WindingMotor/Hub-2.0/documentation/images/Hub-2.0-ECU_INTERFACE.png

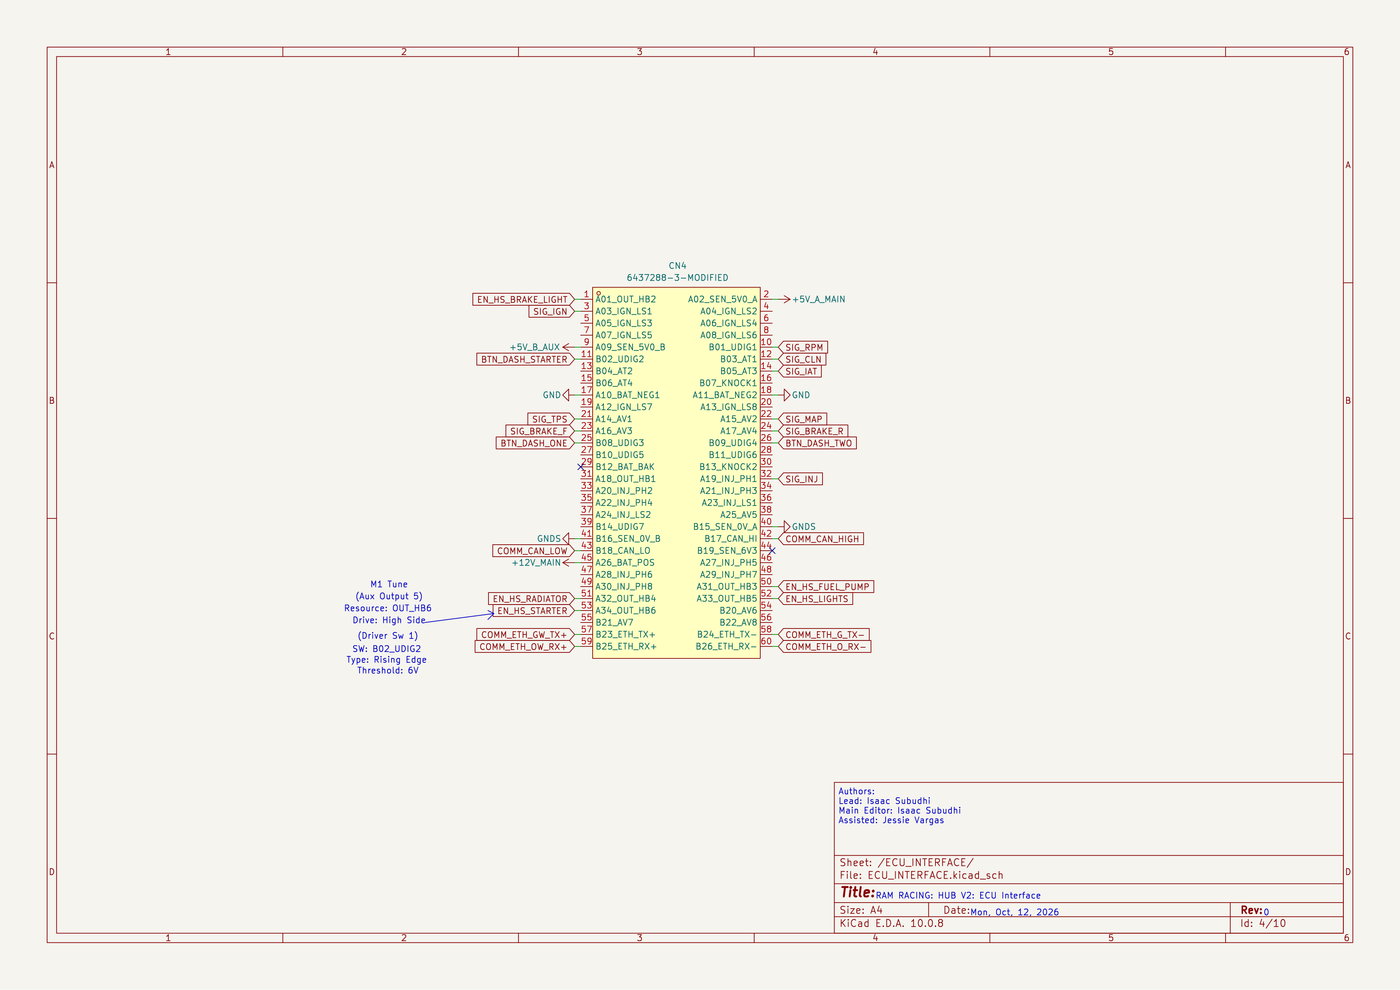
documentation/images/Hub-2.0-ECU_INTERFACE.png
