WindingMotor/Hub-2.0/documentation/images/Hub-2.0-EXTERNAL_CONNECTORS.png

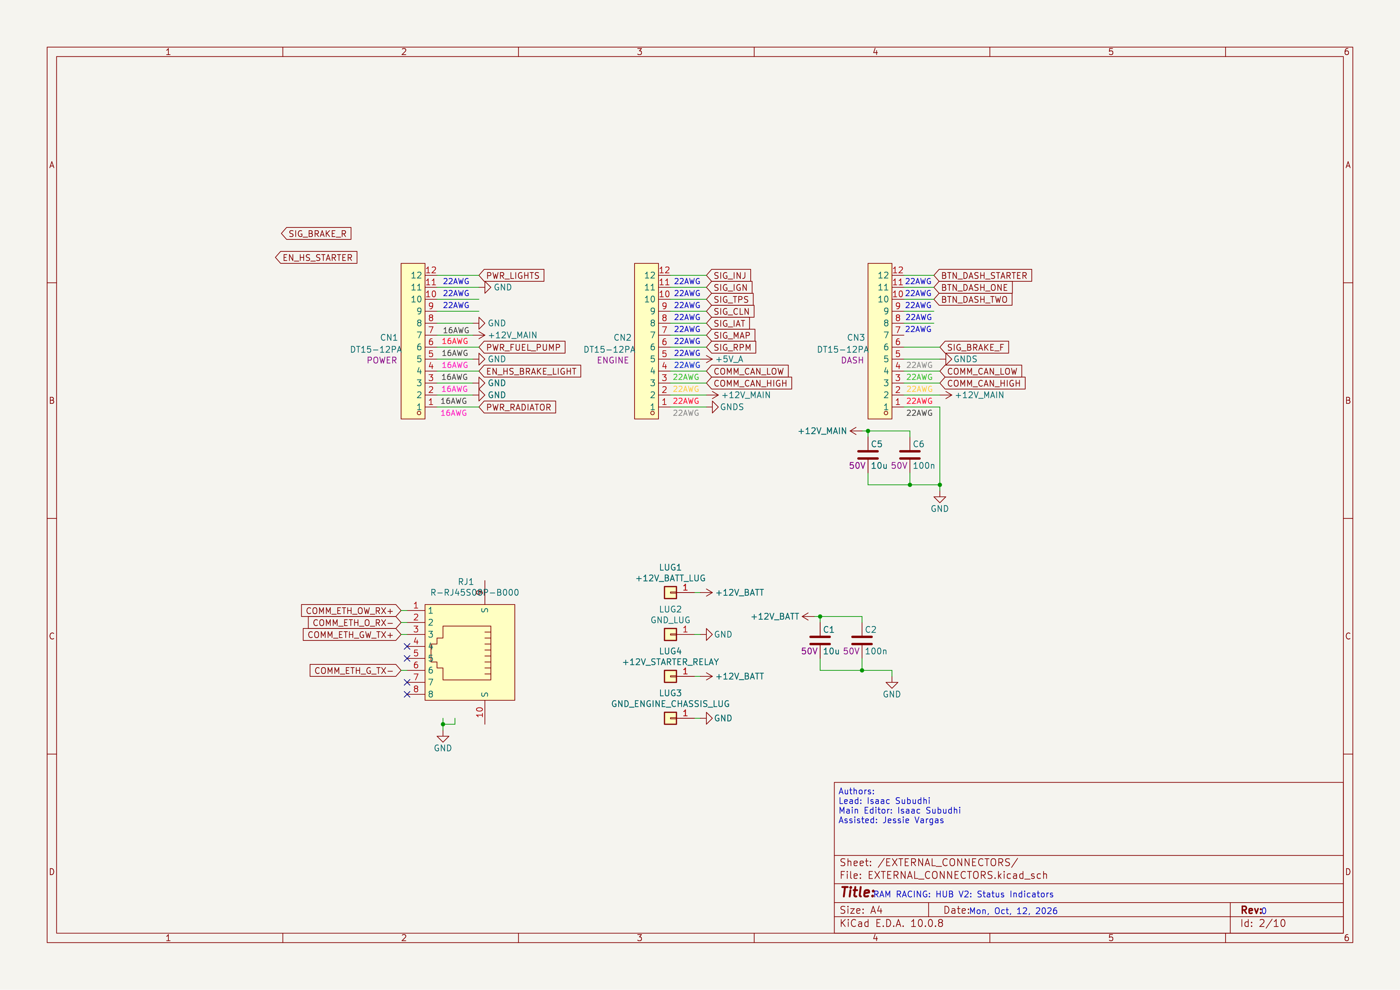
documentation/images/Hub-2.0-EXTERNAL_CONNECTORS.png
