WindingMotor/Hub-2.0/documentation/images/Hub-2.0-LOW_POWER_RELAYS.png

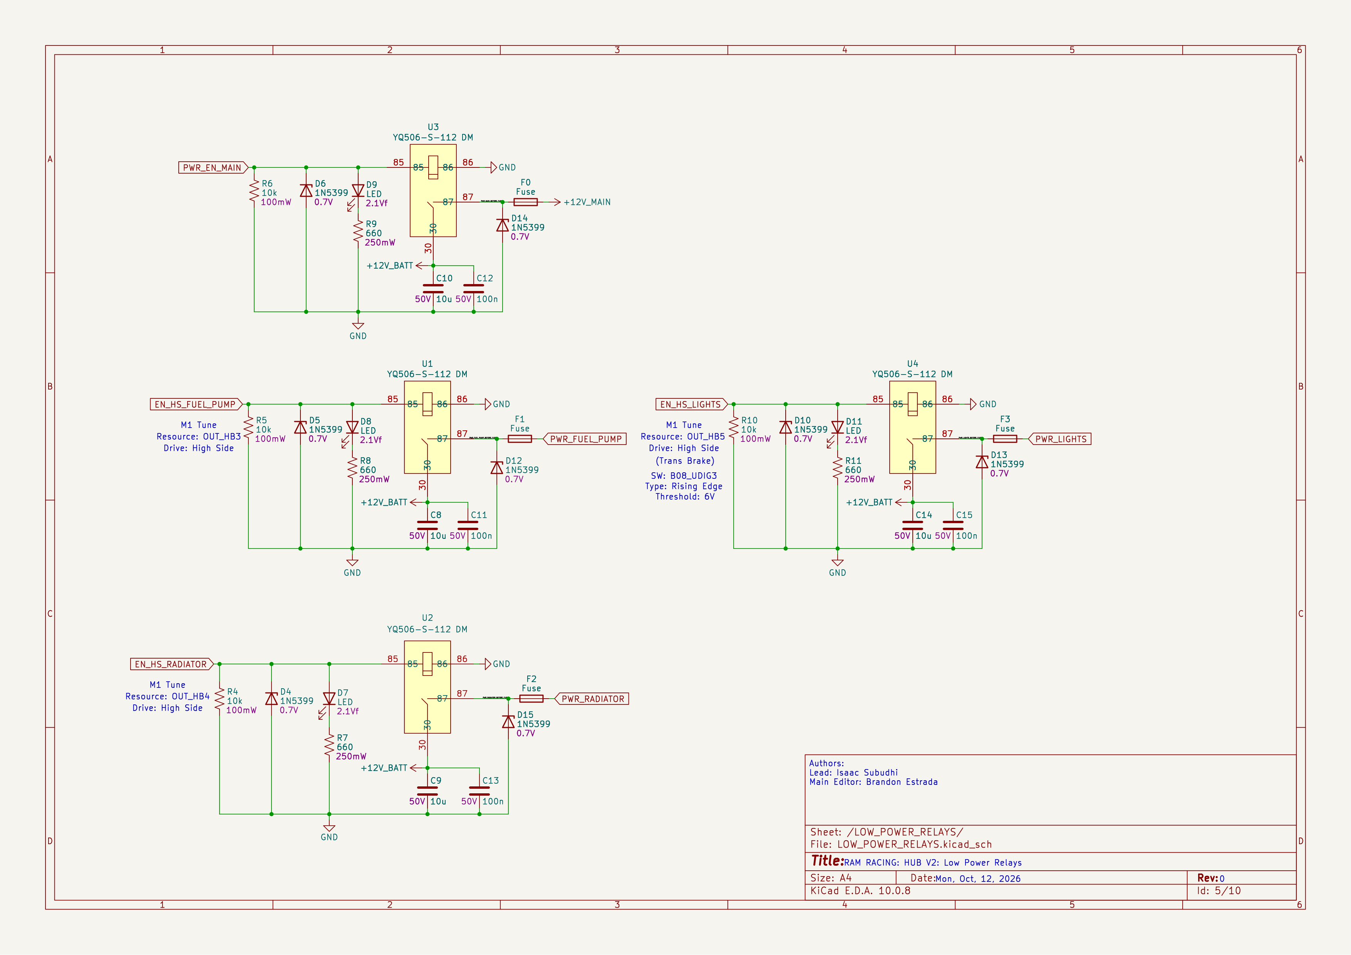
documentation/images/Hub-2.0-LOW_POWER_RELAYS.png
