WindingMotor/Hub-2.0/documentation/images/Hub-2.0-STATUS_INDICATORS.png

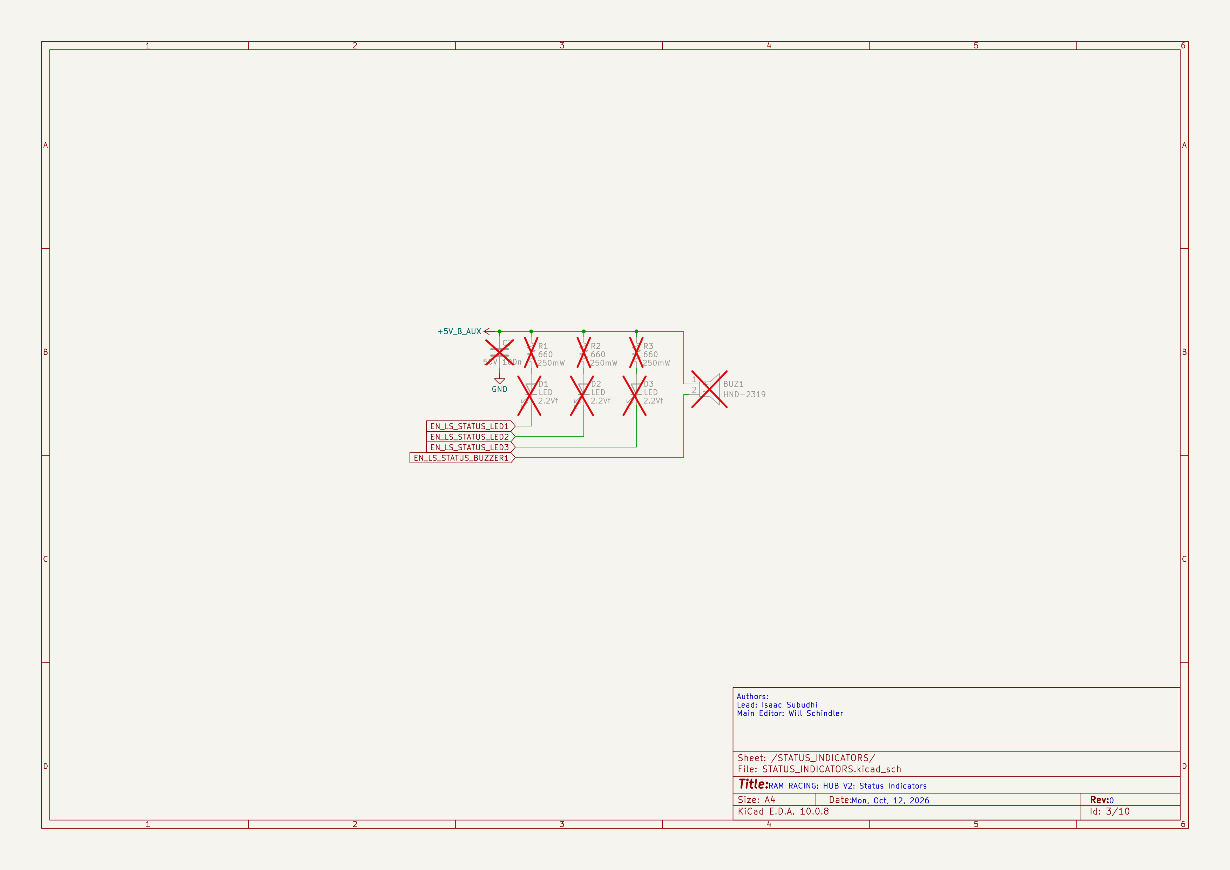
documentation/images/Hub-2.0-STATUS_INDICATORS.png
