WindingMotor/Hub-2.0/documentation/images/Hub-2.0.png

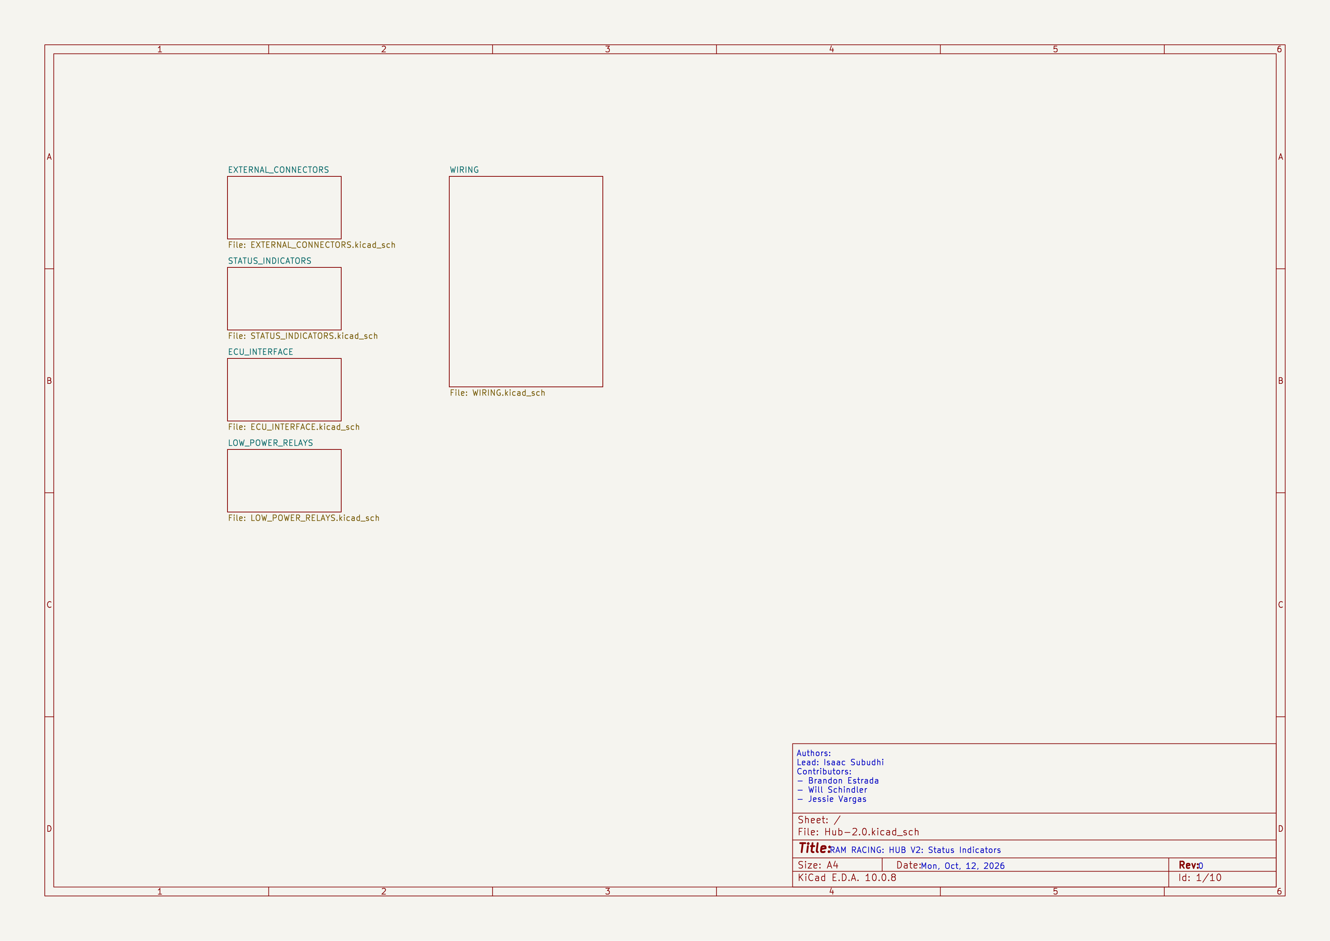
documentation/images/Hub-2.0.png
