WindingMotor/Hub-2.0/documentation/images/Hub-2.0-WIRING-SAFETY.png

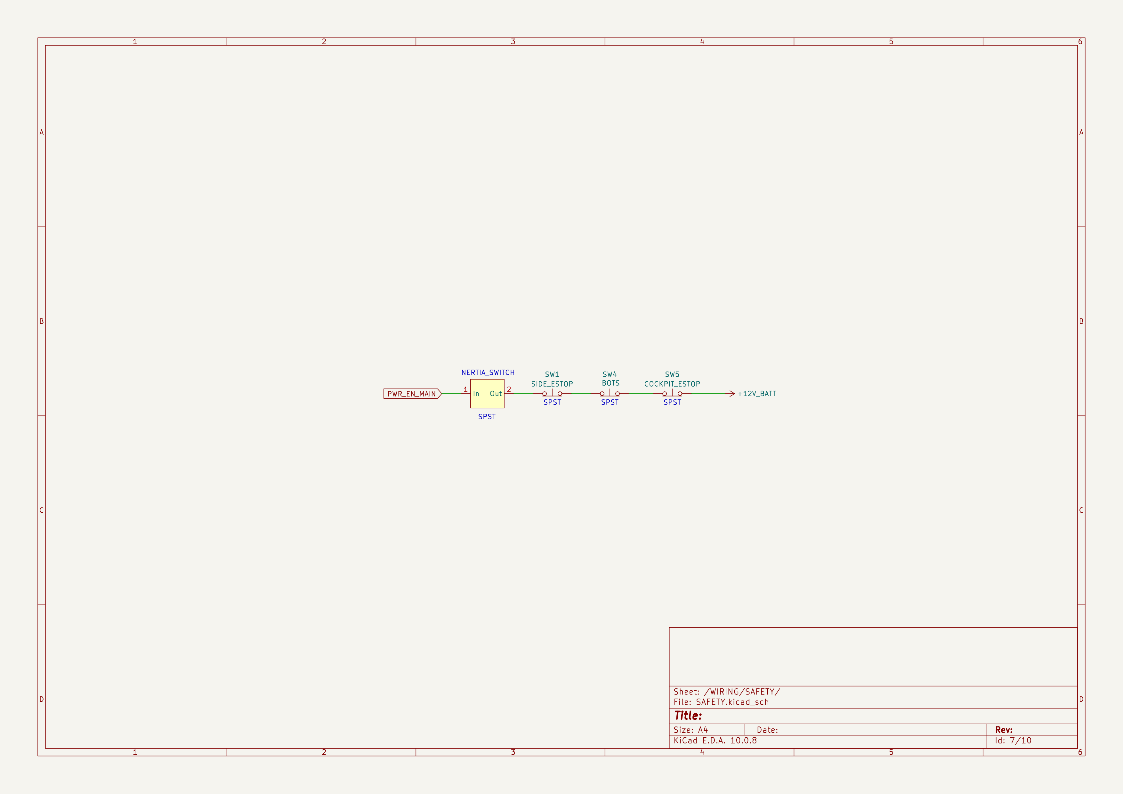
documentation/images/Hub-2.0-WIRING-SAFETY.png
