WindingMotor/Hub-2.0/documentation/images/Hub-2.0.pdf

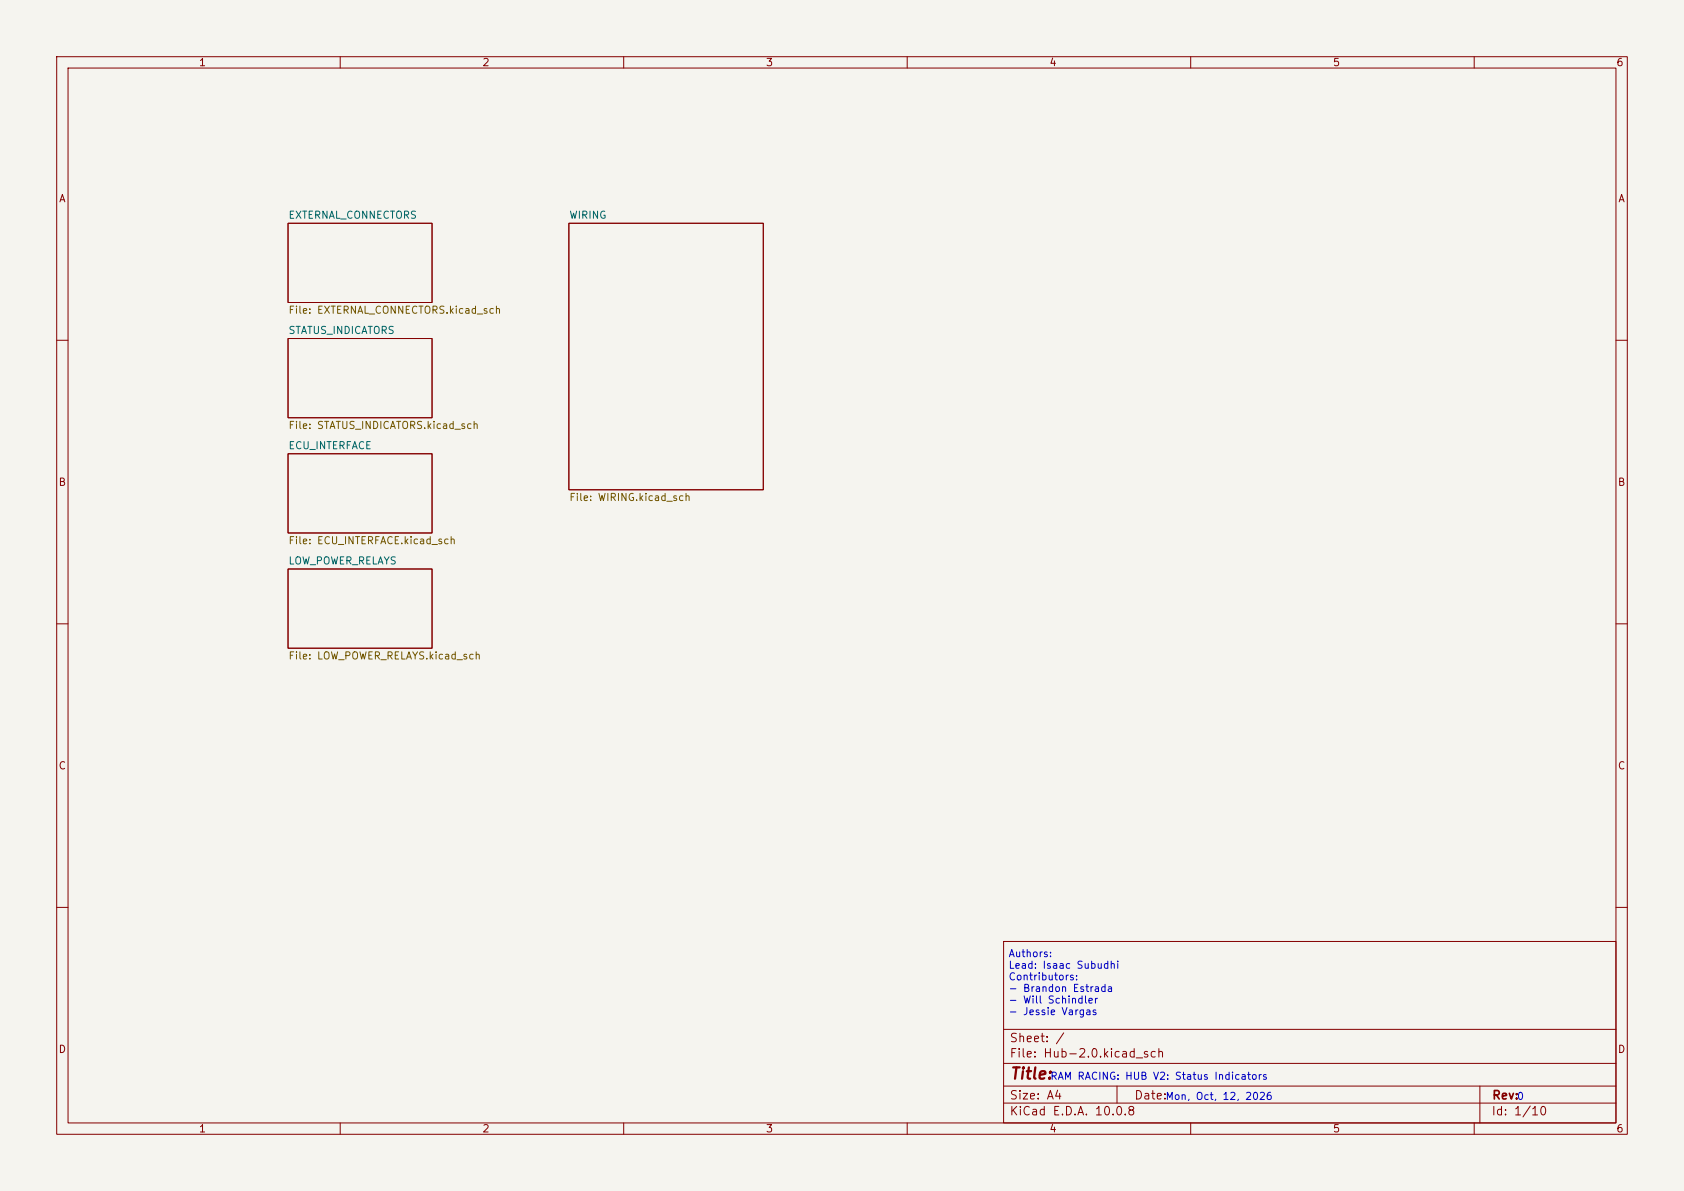
[picture p8: page 1]

Size: A4 | Rev:
KiCad E.D.A. 10.0.8 | Id: 1/10

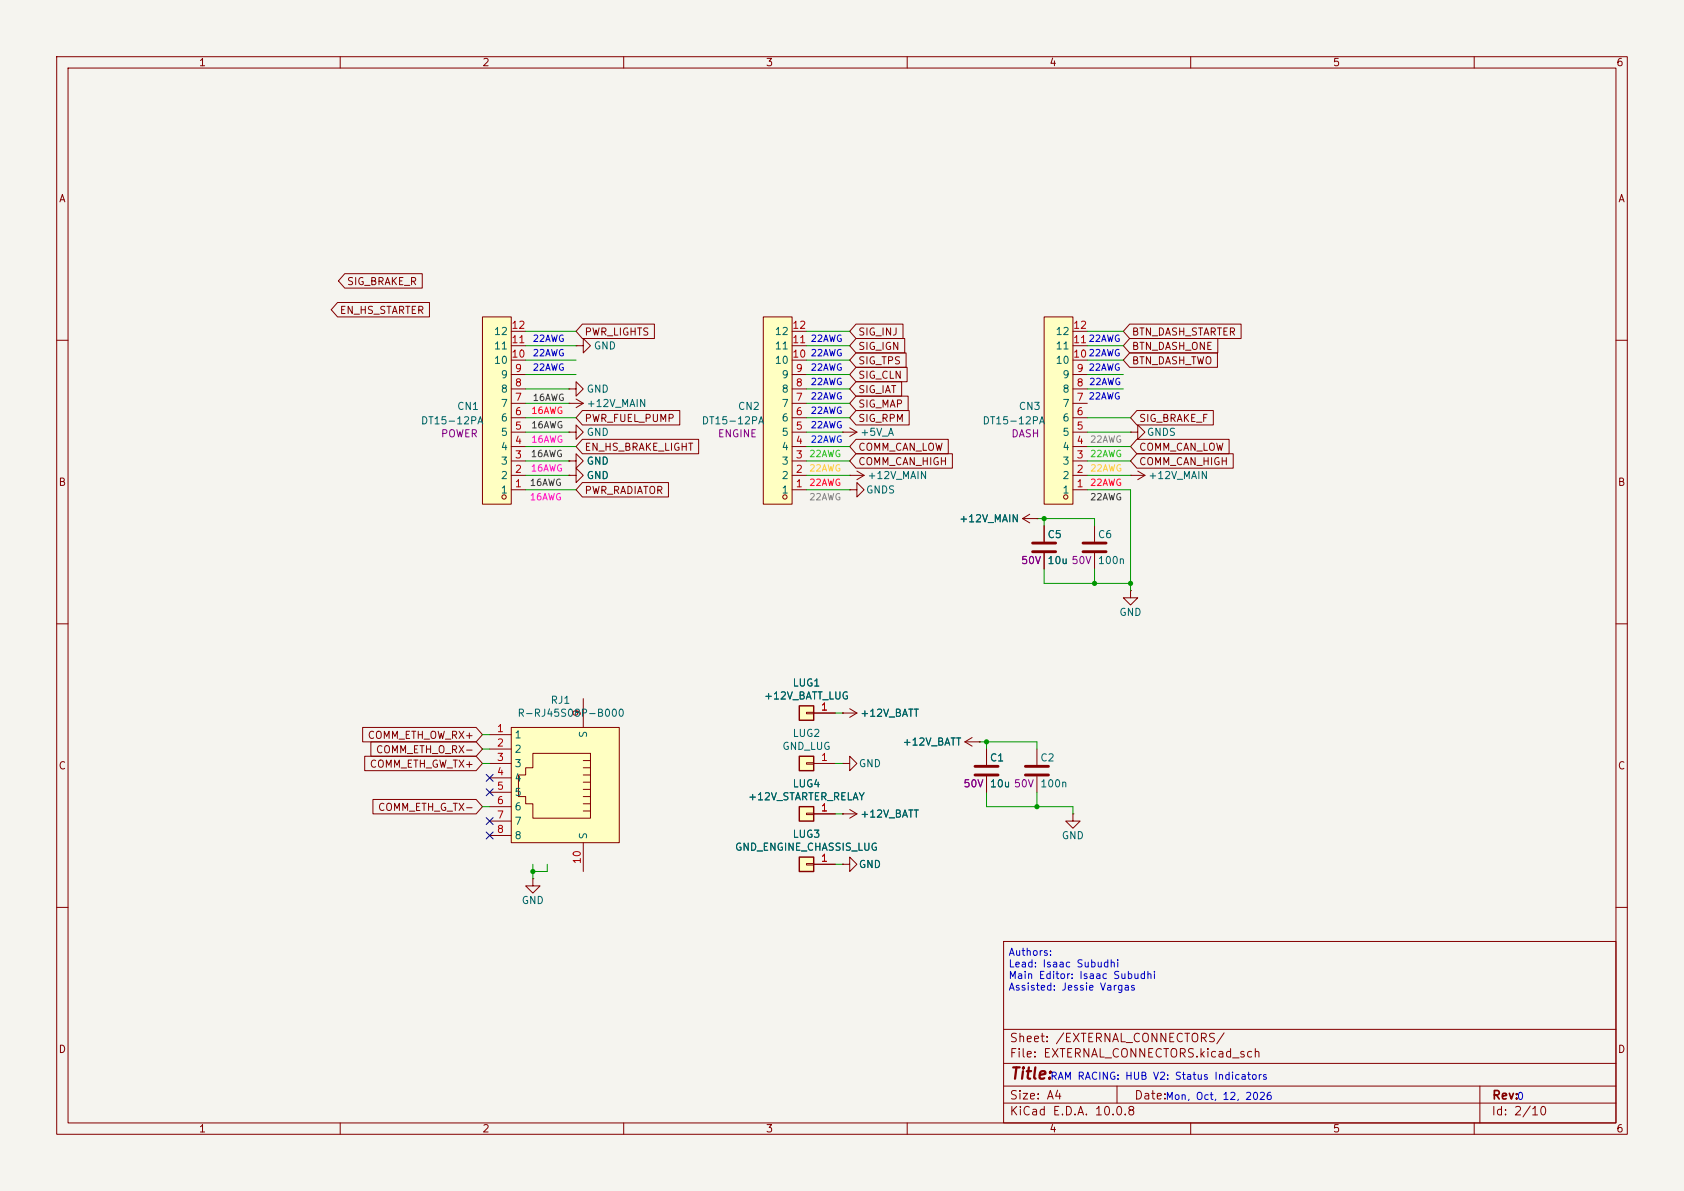
[picture p9: page 2]

Authors: Lead: Isaac Subudhi Main Editor: Isaac Subudhi Assisted: Jessie Vargas

RAM RACING: HUB V2: Status Indicators

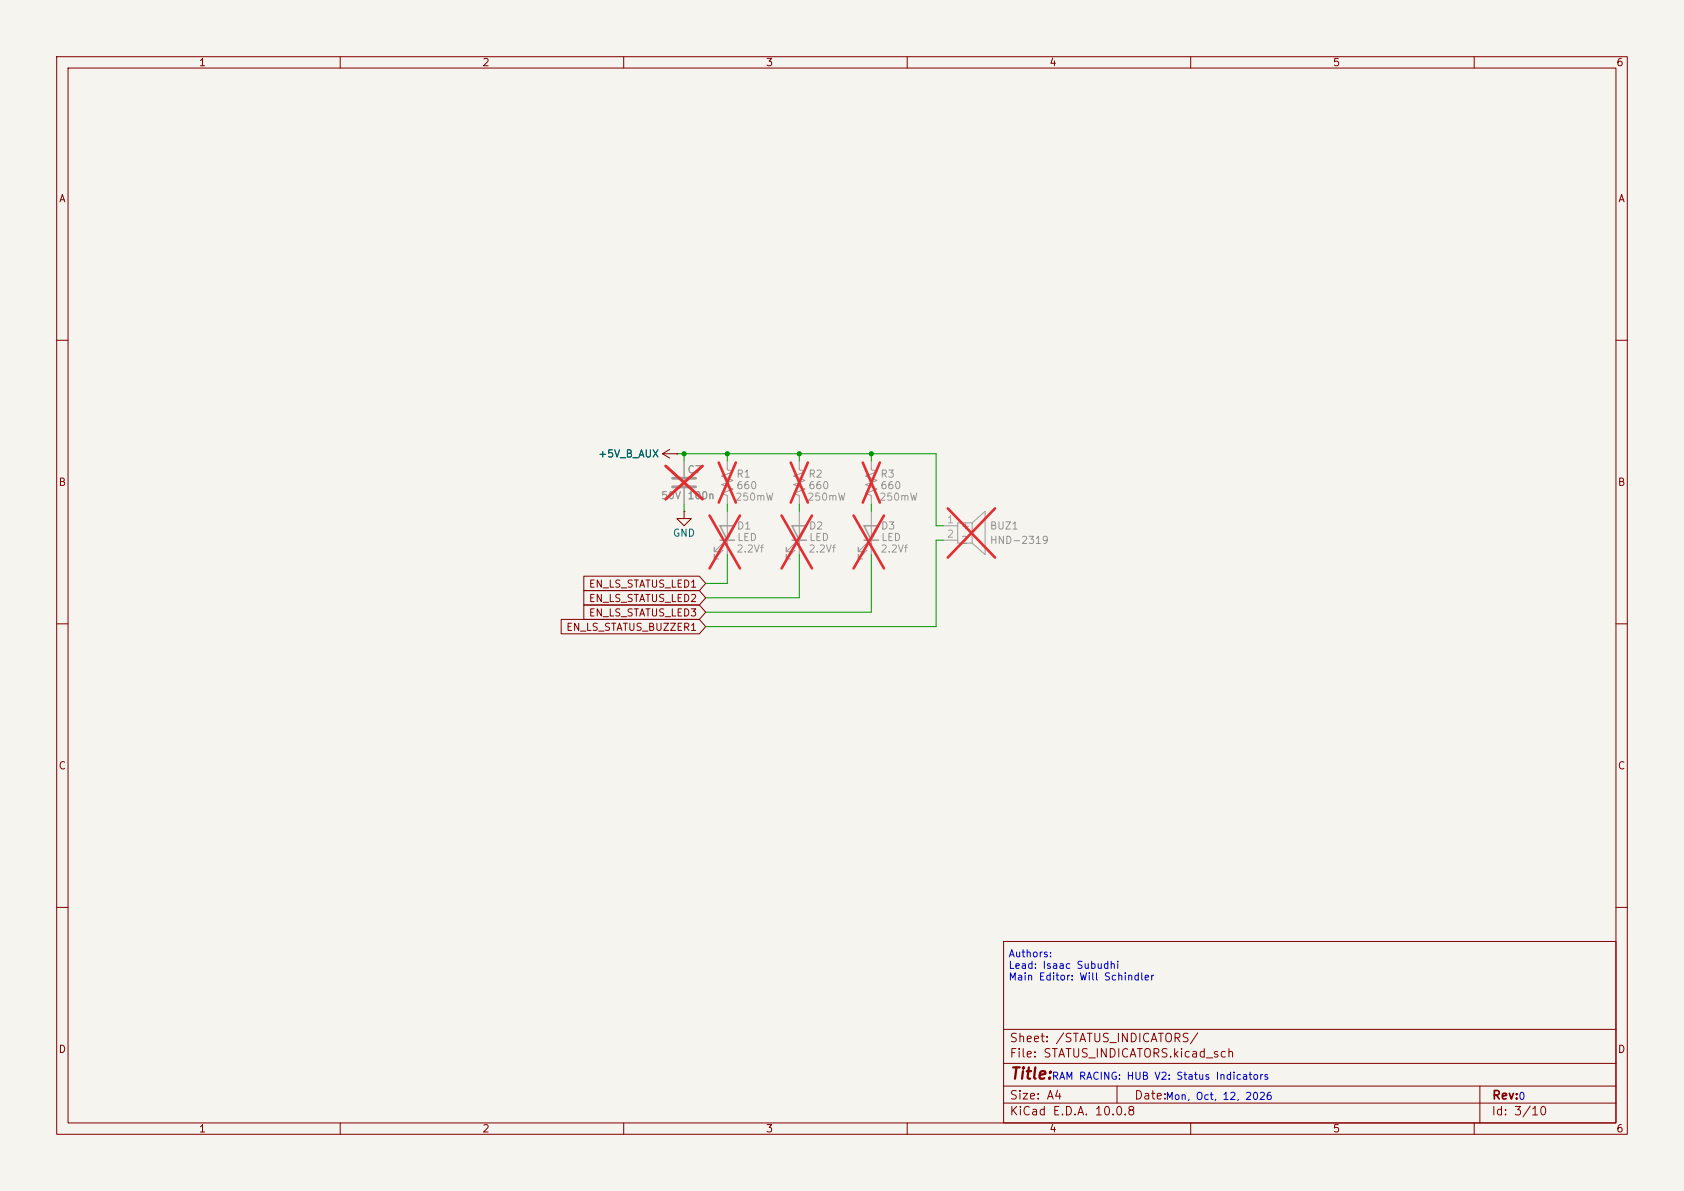
[picture p10: page 3]

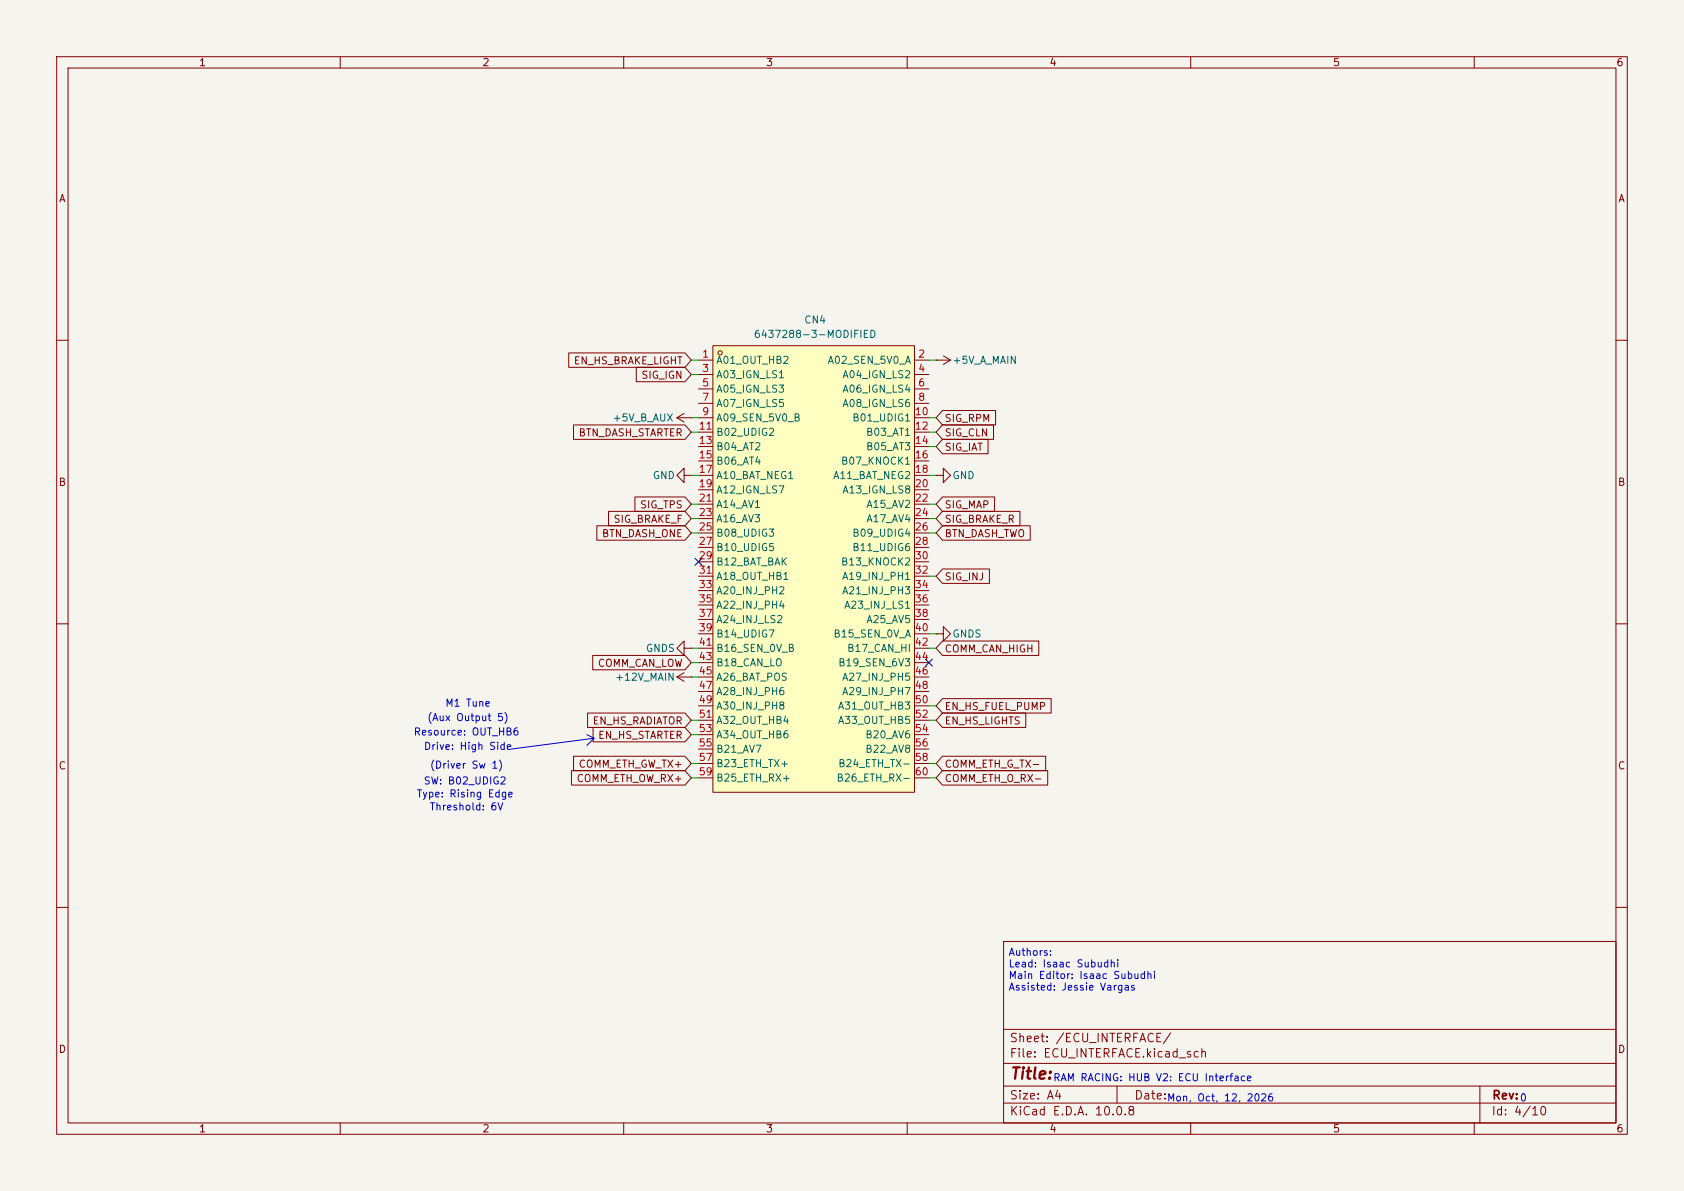
[picture p11: page 4]

Authors: Lead: Isaac Subudhi Main Editor: Isaac Subudhi Assisted: Jessie Vargas M1 Tune
(Aux Output 5) Drive: High Side

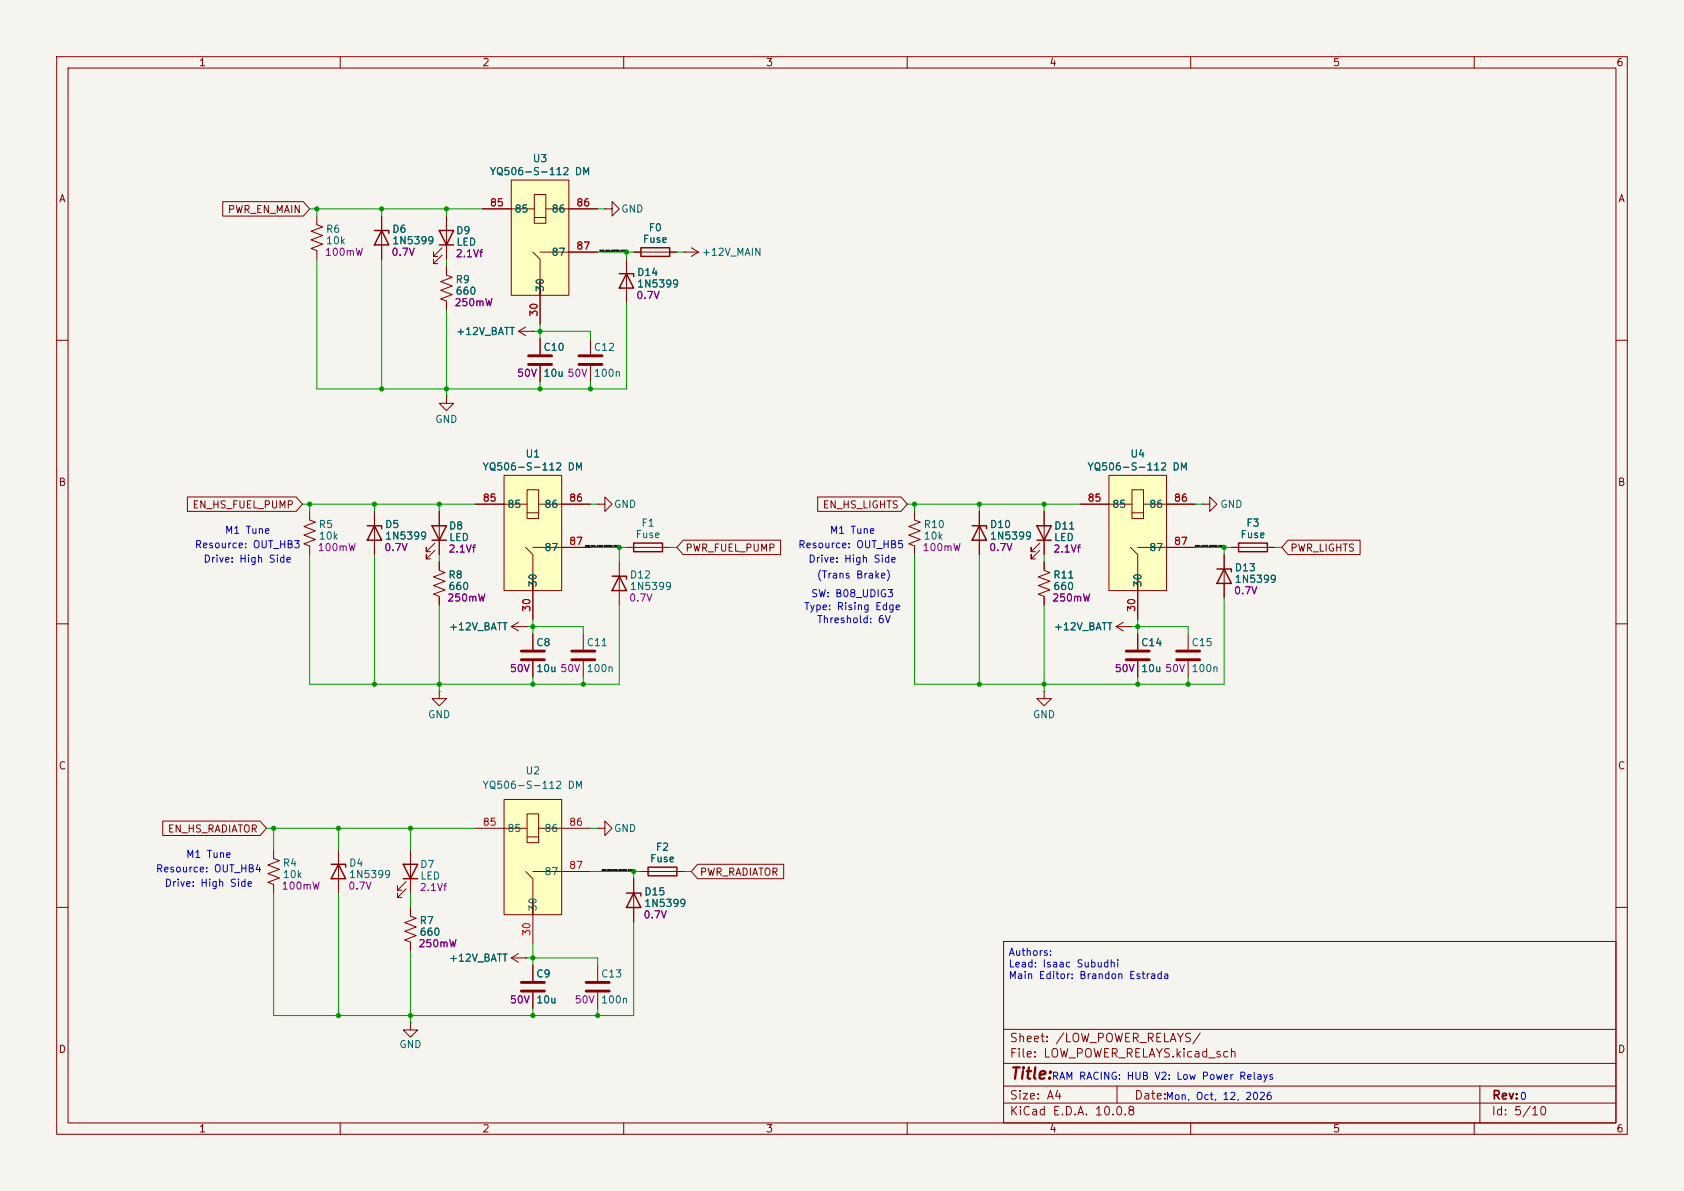
[picture p12: page 5]

(Trans Brake) Resource: OUT_HB5
Type: Rising Edge Drive: High Side SW: B08_UDIG3

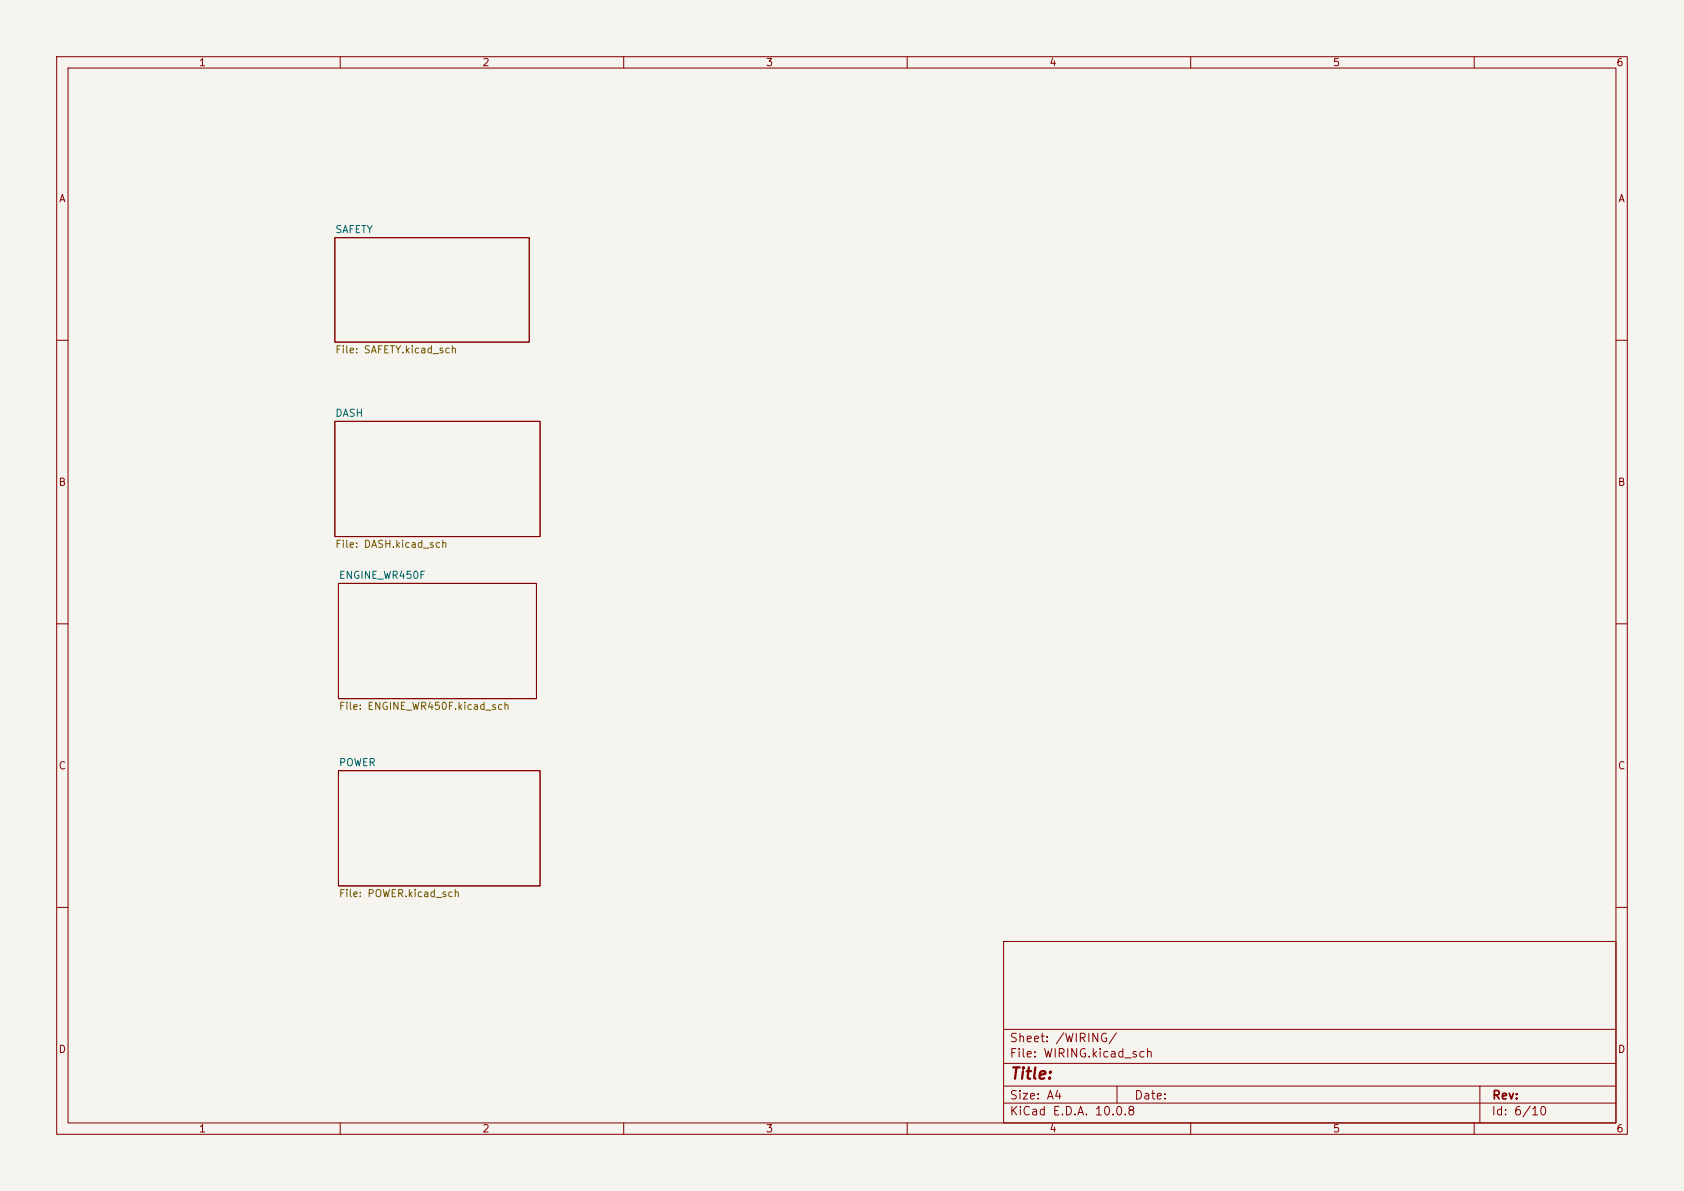
[picture p13: page 6]

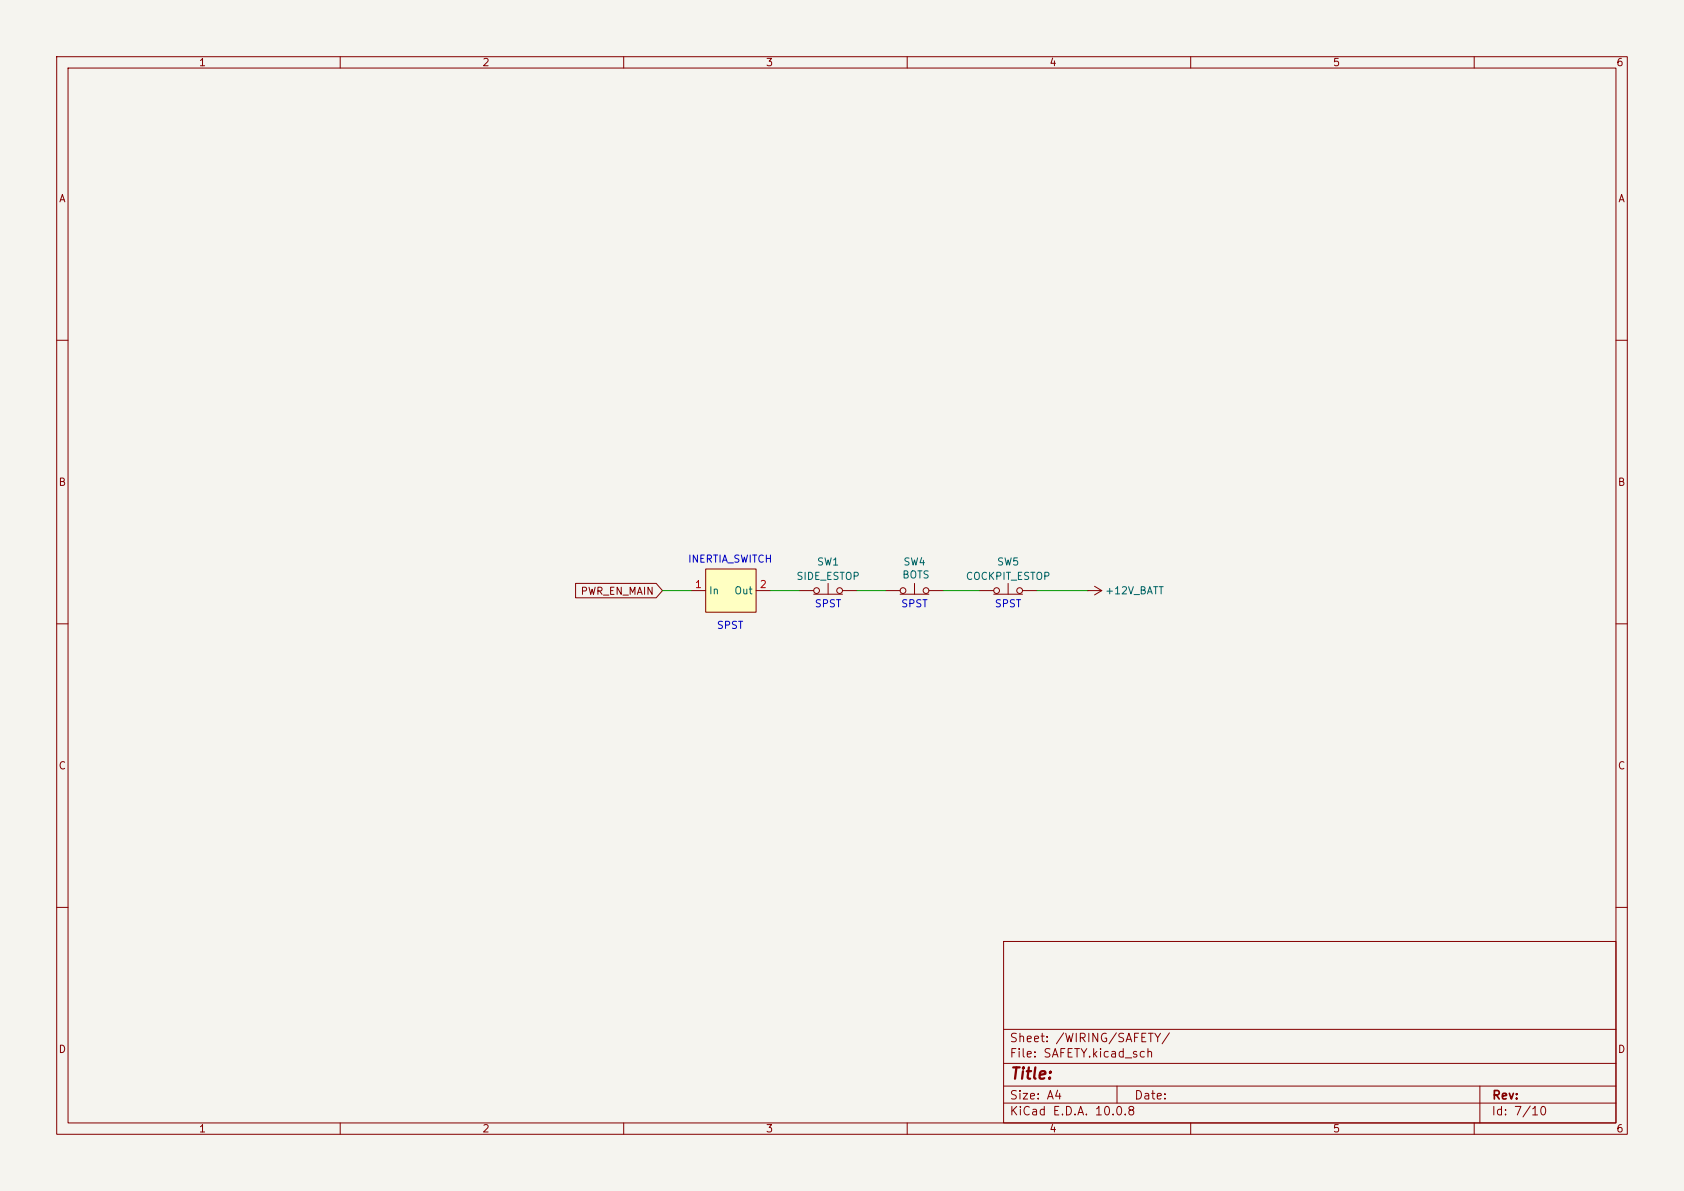
[picture p14: page 7]

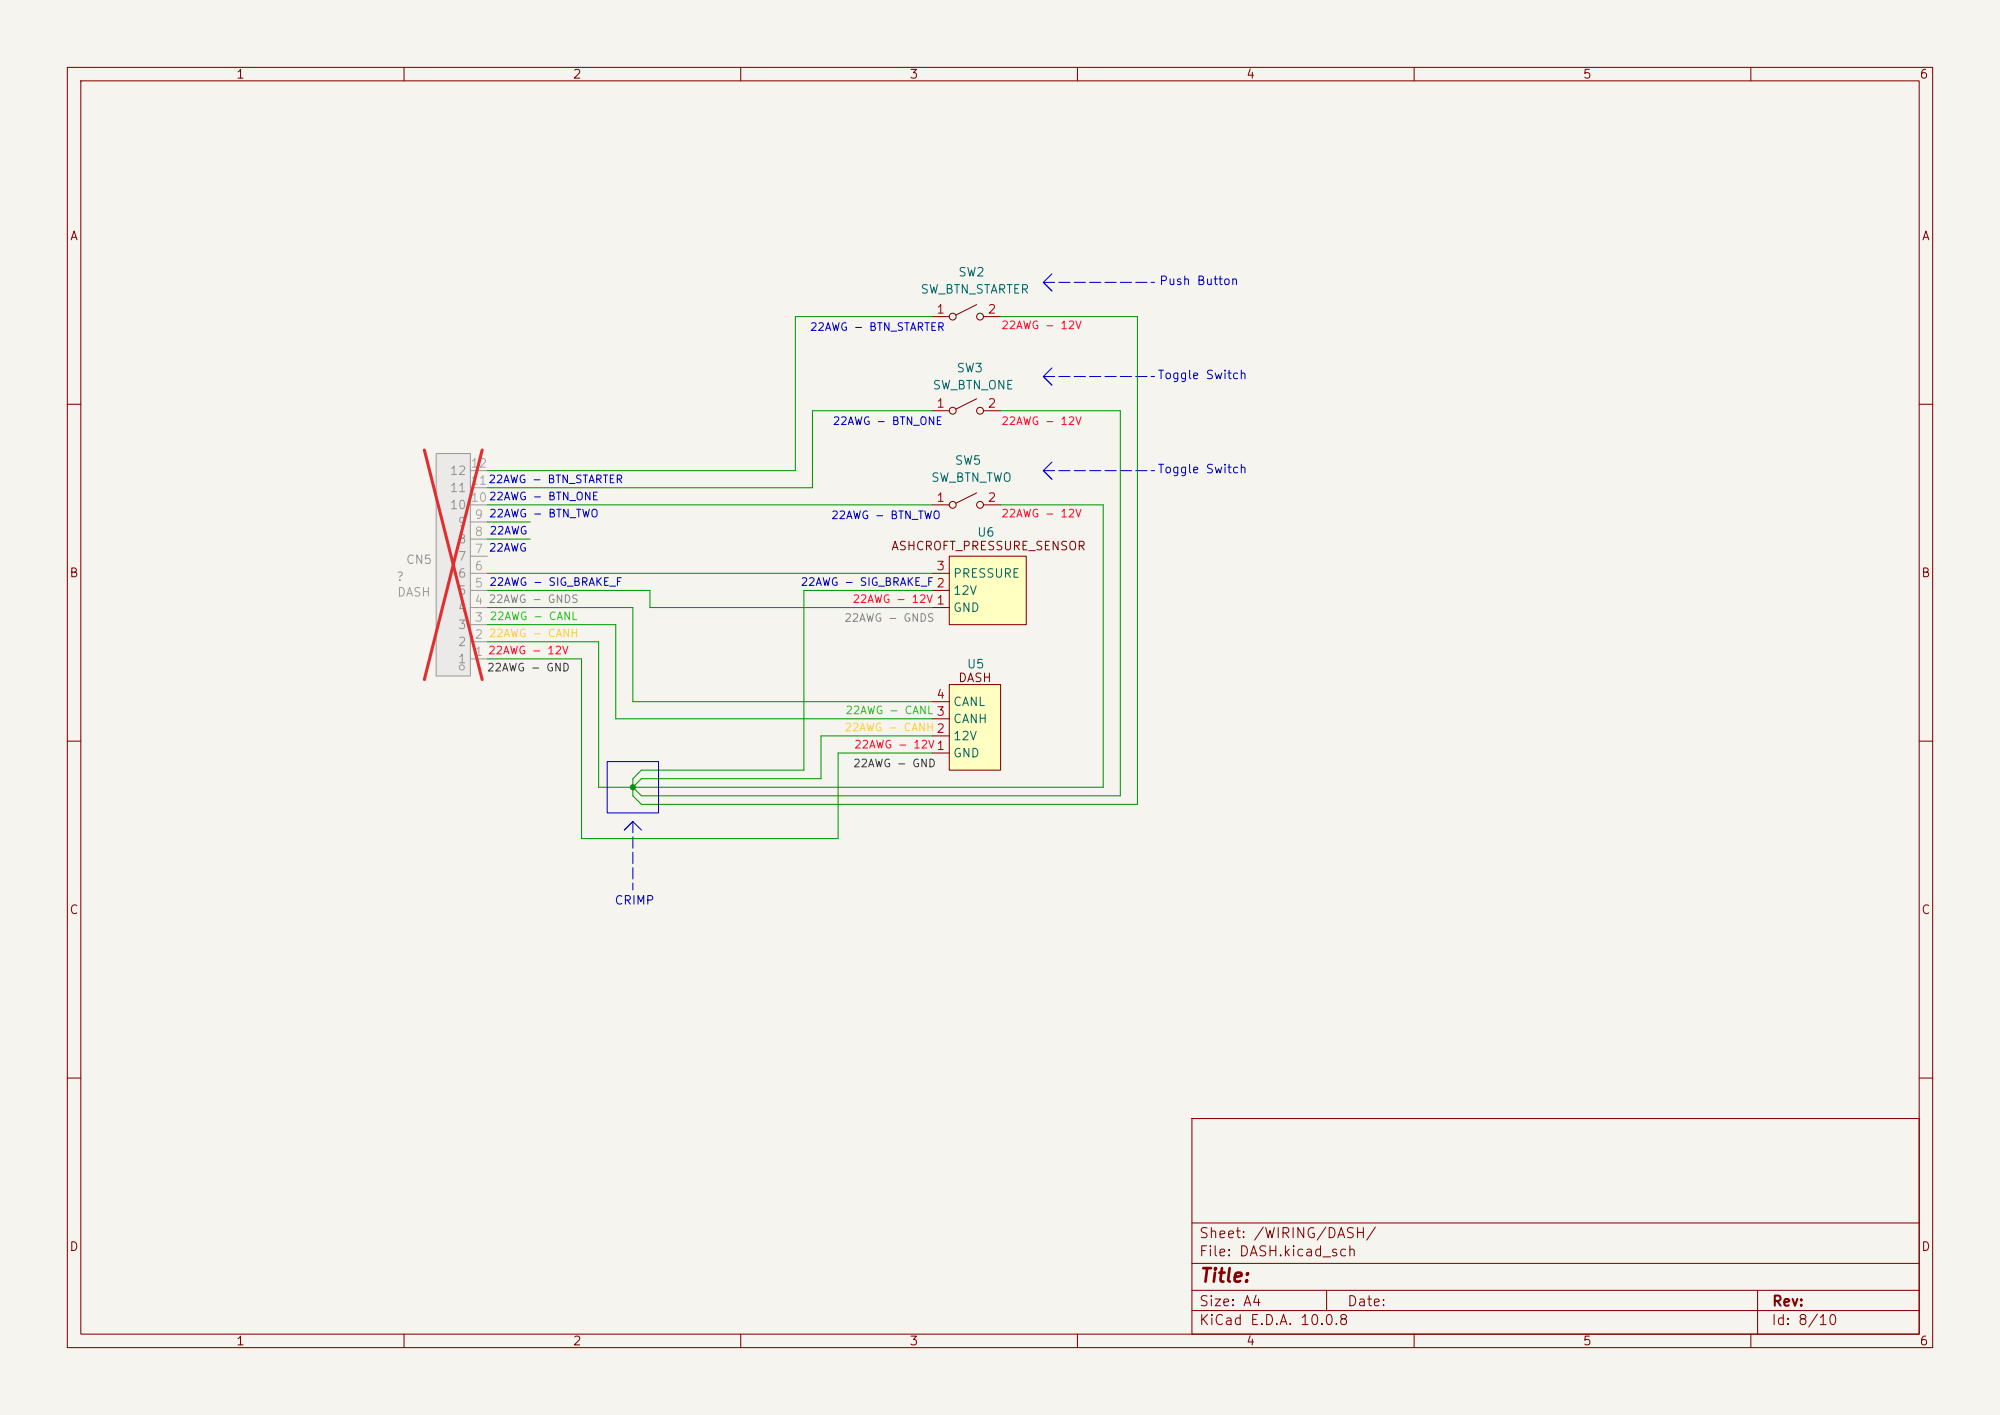
[picture p15: page 8]

Toggle Switch Push Button

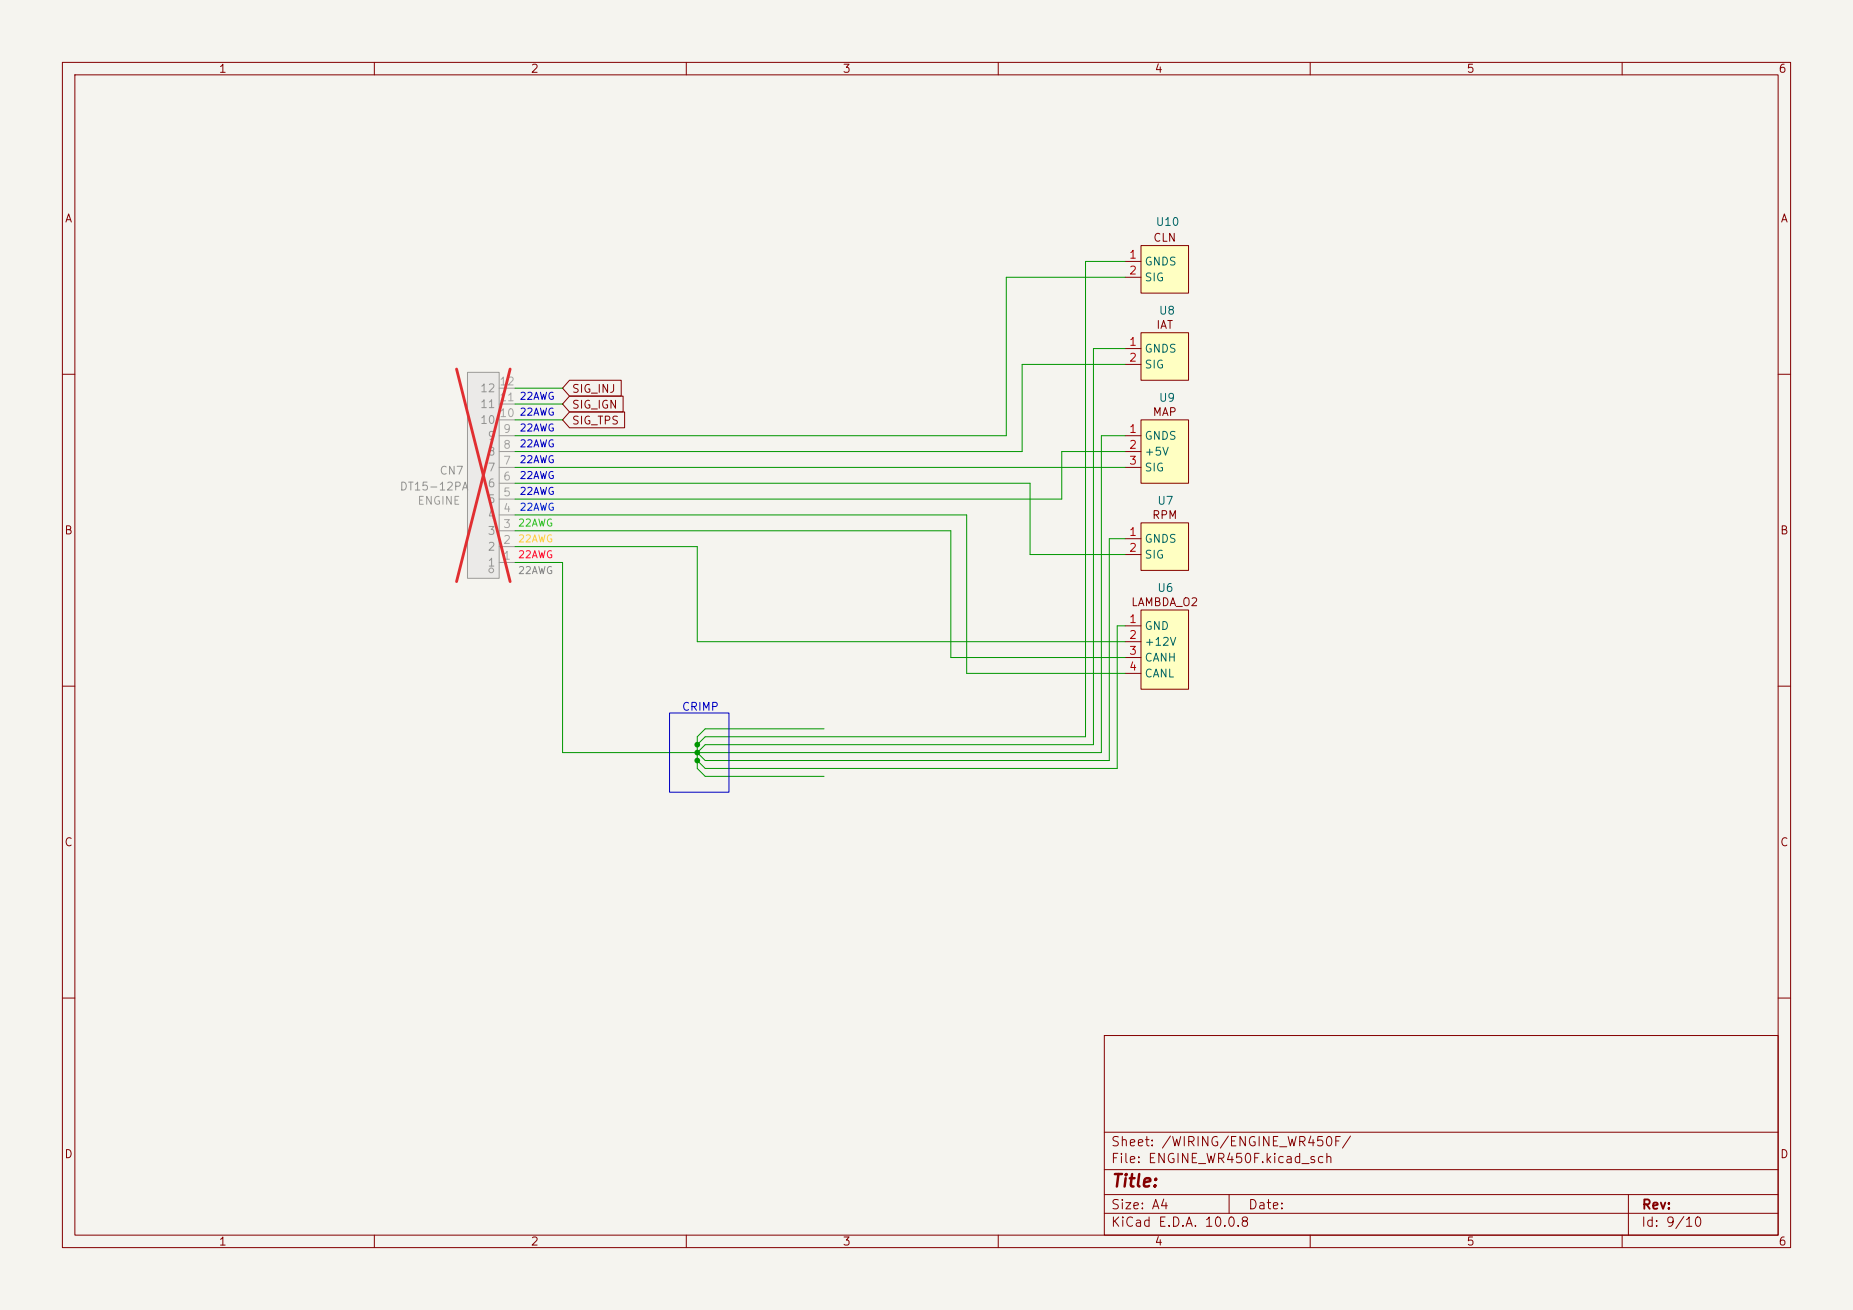
[picture p16: page 9]

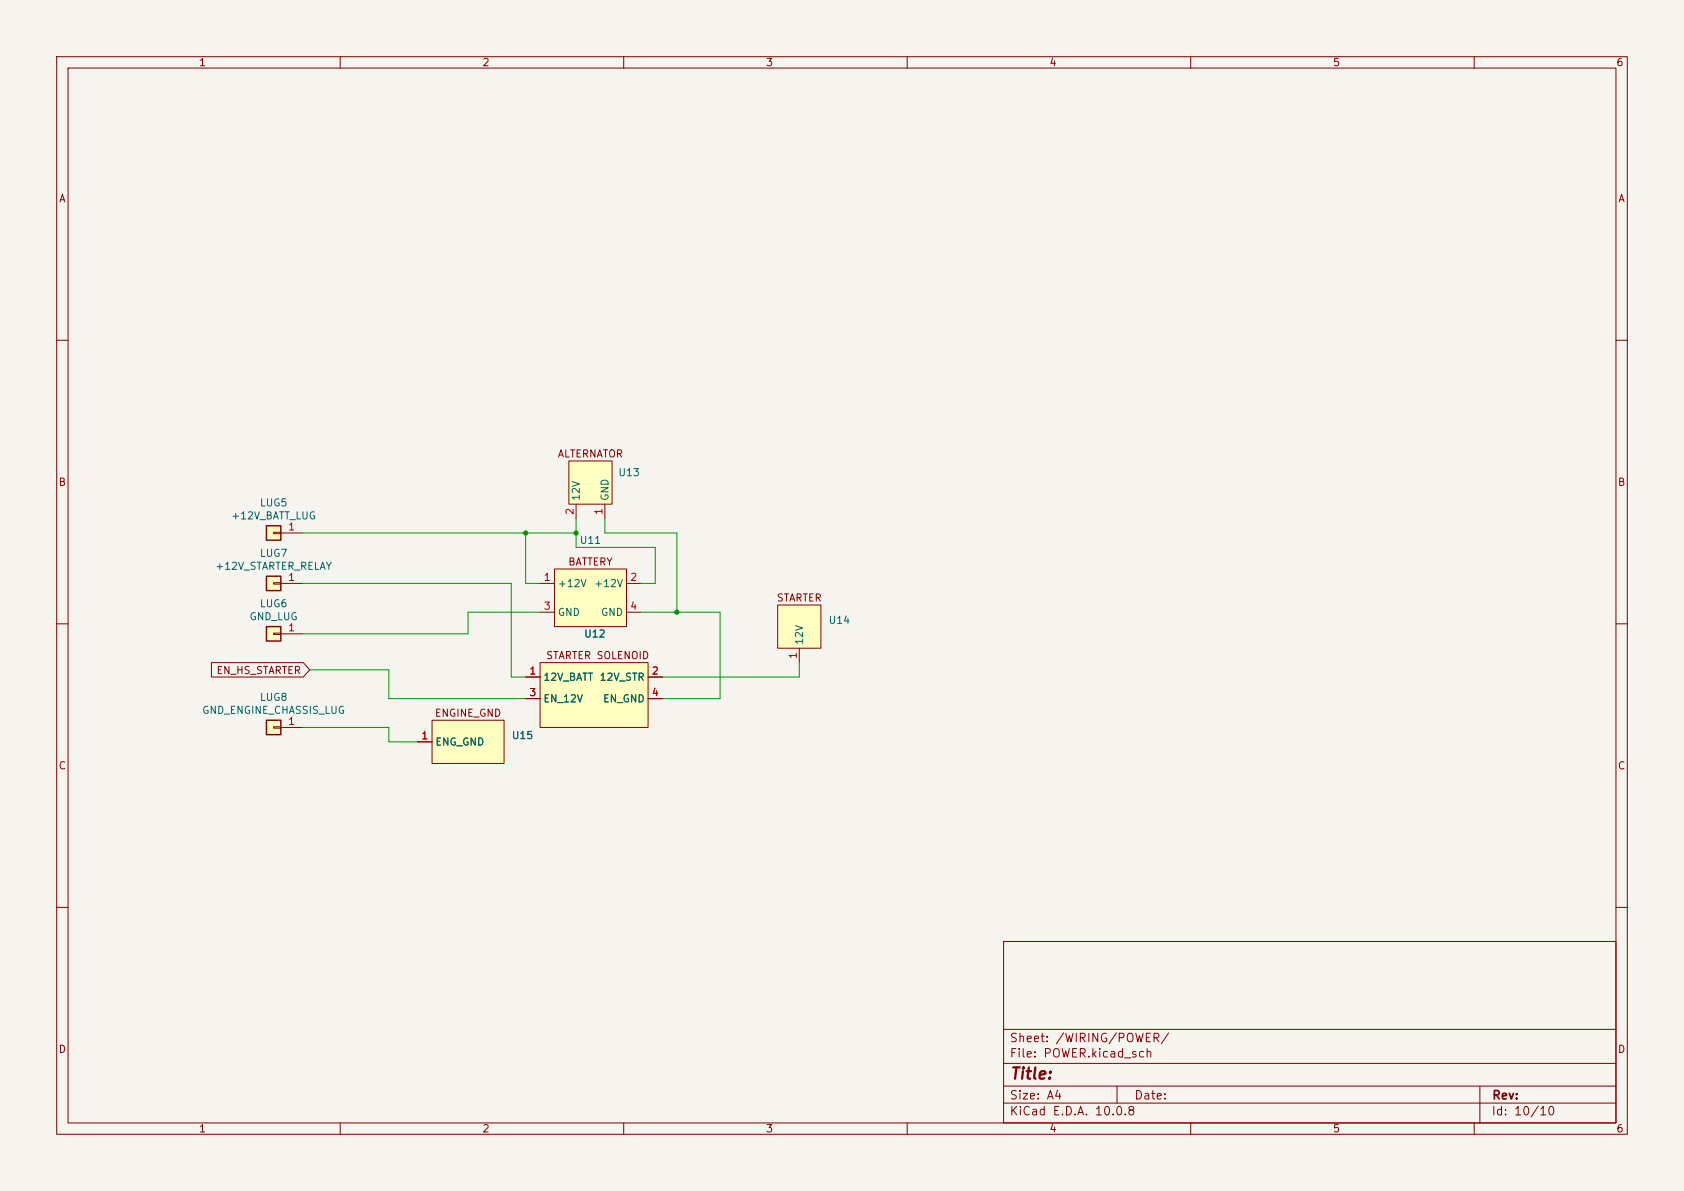
[picture p17: page 10]
