WindingMotor/Hub-2.0/Hub-2.0.kicad_pcb

## KiCad design Hub-2.0.kicad_pcb (2026-11-04)

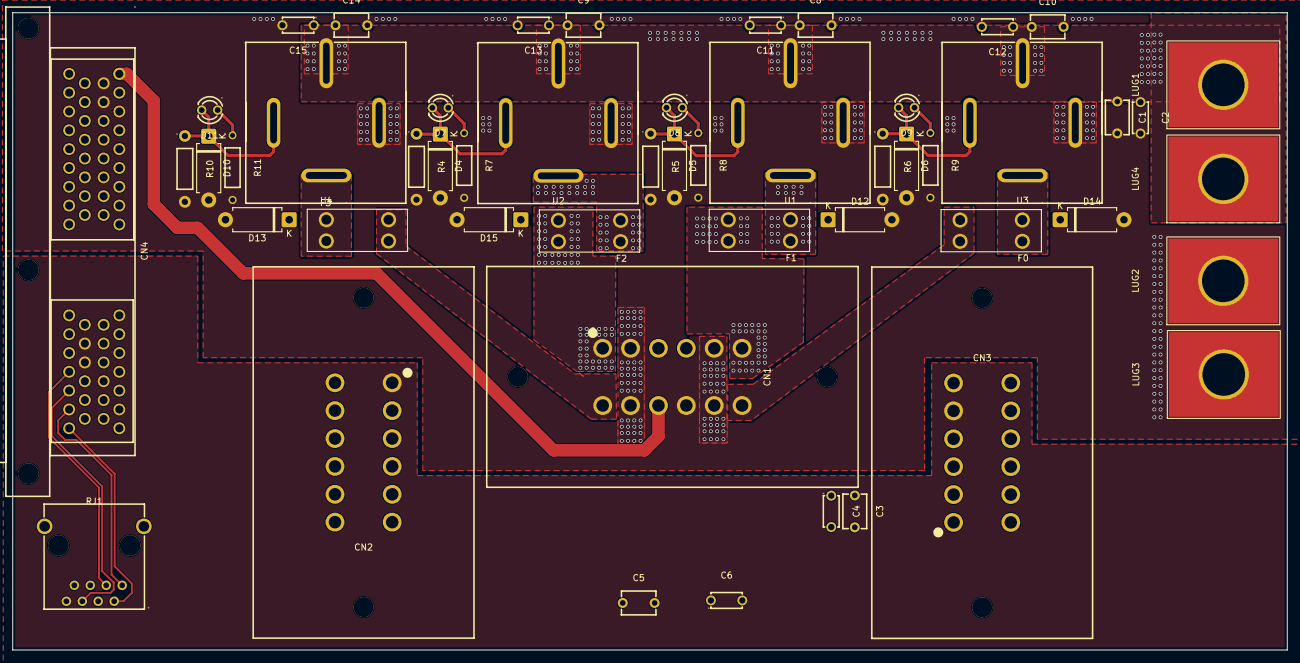
[picture p18: board Hub-2.0.kicad_pcb from above]

Board: 6 copper layers, 203.2 x 101.6 mm, 51 parts (0 on the bottom side), 37 nets.

Parts:
C1, C3, C5, C8, C9, C10, C14: 10u; CAP-TH_L5.5-W3.8-P5.08-D0.5
C2, C4, C6, C11, C12, C13, C15: 100n; CAP-TH_L5.0-W2.5-P5.00-D1.0
CN1, CN2, CN3: DT15-12PA; CONN-TH_DT15-12PA
CN4: 6437288-3-MODIFIED; DSUB-60P_SUPERSEAL
D4, D5, D6, D10, D12, D13, D14, D15: 1N5399; D_DO-15_P10.16mm_Horizontal
D7, D8, D9, D11: LED; LED-TH_BD3.0-P2.54-FD_YELLOW
F0, F1, F2, F3: Fuse; FUSE_3568
LUG1: +12V_BATT_LUG; 1_4_Lug
LUG2: GND_LUG; 1_4_Lug
LUG3: GND_ENGINE_CHASSIS_LUG; 1_4_Lug
LUG4: +12V_STARTER_RELAY; 1_4_Lug
R4, R5, R6, R10: 10k; RES-TH_BD2.5-L6.5-P10.50-D0.6
R7, R8, R9, R11: 660; RES-TH_BD2.4-L6.3-P10.30-D0.6
RJ1: R-RJ45S08P-B000; RJ45-TH_R-RJ45S08P-B000
U1, U2, U3, U4: YQ506-S-112 DM; RELAY-TH_YQ506-S-112DM

Connections:
+12V_BATT: C1.1, C2.1, C8.1, C9.1, C10.1, C11.1, C12.1, C13.1, C14.1, C15.1, LUG1.1 (Pin_1_1), LUG4.1 (Pin_1_1), U1.30, U2.30, U3.30, U4.30
+12V_MAIN: C3.1, C4.1, C5.1, C6.1, CN1.7, CN2.2, CN3.2, CN4.45 (A26_BAT_POS), F0.2
/LOW_POWER_RELAYS/PWR_FUEL_PUMP_BEFORE_FUSE: D12.1 (K), F1.1, U1.87
/LOW_POWER_RELAYS/PWR_LIGHTS_BEFORE_FUSE: D13.1 (K), F3.1, U4.87
/LOW_POWER_RELAYS/PWR_MAIN_BEFORE_FUSE: D14.1 (K), F0.1, U3.87
/LOW_POWER_RELAYS/PWR_RADIATOR_BEFORE_FUSE: D15.1 (K), F2.1, U2.87
BTN_DASH_ONE: CN3.11, CN4.25 (B08_UDIG3)
BTN_DASH_STARTER: CN3.12, CN4.11 (B02_UDIG2)
BTN_DASH_TWO: CN3.10, CN4.26 (B09_UDIG4)
COMM_CAN_HIGH: CN2.3, CN3.3, CN4.42 (B17_CAN_HI)
COMM_CAN_LOW: CN2.4, CN3.4, CN4.43 (B18_CAN_LO)
COMM_ETH_GW_TX+: CN4.57 (B23_ETH_TX+), RJ1.3
COMM_ETH_G_TX-: CN4.58 (B24_ETH_TX-), RJ1.6
COMM_ETH_OW_RX+: CN4.59 (B25_ETH_RX+), RJ1.1
COMM_ETH_O_RX-: CN4.60 (B26_ETH_RX-), RJ1.2
EN_HS_BRAKE_LIGHT: CN1.10, CN4.1 (A01_OUT_HB2)
EN_HS_FUEL_PUMP: CN4.50 (A31_OUT_HB3), D5.1 (K), D8.2 (A), R5.1, U1.85
EN_HS_LIGHTS: CN4.52 (A33_OUT_HB5), D10.1 (K), D11.2 (A), R10.1, U4.85
EN_HS_RADIATOR: CN4.51 (A32_OUT_HB4), D4.1 (K), D7.2 (A), R4.1, U2.85
GND: C1.2, C2.2, C3.2, C4.2, C5.2, C6.2, C8.2, C9.2, C10.2, C11.2, C12.2, C13.2, C14.2, C15.2, CN1.2, CN1.5, CN1.8, CN1.9, CN1.11, CN3.1, CN4.17 (A10_BAT_NEG1), CN4.18 (A11_BAT_NEG2), D4.2 (A), D5.2 (A), D6.2 (A), D10.2 (A), D12.2 (A), D13.2 (A), D14.2 (A), D15.2 (A), LUG2.1 (Pin_1_1), LUG3.1 (Pin_1_1), R4.2, R5.2, R6.2, R7.2, R8.2, R9.2, R10.2, R11.2, U1.86, U2.86, U3.86, U4.86
GNDS: CN2.1, CN3.5, CN4.40 (B15_SEN_0V_A), CN4.41 (B16_SEN_0V_B)
unnamed: D7.1 (K), R7.1
unnamed: D8.1 (K), R8.1
unnamed: D9.1 (K), R9.1
unnamed: D11.1 (K), R11.1
PWR_EN_MAIN: D6.1 (K), D9.2 (A), R6.1, U3.85
PWR_FUEL_PUMP: CN1.6, F1.2
PWR_LIGHTS: CN1.12, F3.2
PWR_RADIATOR: CN1.1, F2.2
SIG_BRAKE_F: CN3.6, CN4.23 (A16_AV3)
SIG_CLN: CN2.9, CN4.12 (B03_AT1)
SIG_IAT: CN2.8, CN4.14 (B05_AT3)
SIG_IGN: CN2.11, CN4.3 (A03_IGN_LS1)
SIG_INJ: CN2.12, CN4.32 (A19_INJ_PH1)
SIG_MAP: CN2.7, CN4.22 (A15_AV2)
SIG_RPM: CN2.6, CN4.10 (B01_UDIG1)
SIG_TPS: CN2.10, CN4.21 (A14_AV1)
