WindingMotor/Hub-2.0/(commit log)

2026-09-02 SCH Save
    [Hub-2.0.kicad_pcb, Hub-2.0.kicad_sch]
2026-09-09 PCB Save
    [Hub-2.0.kicad_pcb]
2026-10-07 Add KiCad project settings
2026-10-07 Track complete EasyEDA libraries
2026-10-12 Modify Status Schematic
    Added 3 THT LEDS, 3 THT Resistors, 1 Capacitor, and 1 Active Buzzer
2026-10-12 Modified Relay Page to add Lights, Radiator, and Fuel Pump
2026-10-12 Update hub design and add RJ45 connector
2026-10-12 Cleanup schematics a little bit
2026-10-13 Update schematic documentation [skip ci]
2026-10-14 Modified Relay Layout
    Added fourth relay to the right side of other three relays
2026-10-19 Started car wiring sch
2026-10-22 Relay layout done, pinout assignments, M1 Notes, and 04 Sch Start
2026-10-28 High current layout work & Simulation
2026-11-02 Configure Prism README and interactive assembly view
2026-11-02 Moved Power Pins - WIP
2026-11-02 Added Dash Wiring
    - Created wiring diagram for the Dash PCB
    - Added starter push button
    - Added two toggle switches
    - Added Ashcroft Pressure Sensor symbol
    - Added Dash symbol
2026-11-02 Optimized Power Pins - WIP
2026-11-02 Satefy Sensor Schematic
    - created Inertia Switch
    - connected Side, BOTS, and Cockpit ESTOP
    - wired safety sensor
2026-11-02 Optimized Radiator Power Pins - WIP
2026-11-04 Optimized Rad/Gnd Connectors - WIP
2026-11-04 Initial-powersheet-changes
    - Added Battery Symbol
    - Added Power Sheet
2026-11-06 POWER Schematic
    Made a power schematic and created symbols for alternator, starter solenoid, and battery
